AmaeyAdvait/BCD-Single-Digit-Multiplier/(list of files, drawings)

Other design files:
bcd_multiplier_Amaey_24EC10057.circ
logi7400ic (1).circ
