AmaeyAdvait/BCD-Single-Digit-Multiplier/BCD_Multiplier_Verilog/BCD_Multiplier_bcd7seg.v

// Programmer's Log: BCD_Multiplier_bcd7seg.v
// Common-anode style active-low 7-seg decoder (2 IC7447's: One to display the ten's digit
// and the other for the units.)

module BCD_multiplier_bcd7seg(
    input  [3:0] bcd,
    output reg [6:0] seg // seg = {g,f,e,d,c,b,a}
);

    always @(*) begin
        case (bcd)
            4'd0: seg = 7'b1000000;
            4'd1: seg = 7'b1111001;
            4'd2: seg = 7'b0100100;
            4'd3: seg = 7'b0110000;
            4'd4: seg = 7'b0011001;
            4'd5: seg = 7'b0010010;
            4'd6: seg = 7'b0000010;
            4'd7: seg = 7'b1111000;
            4'd8: seg = 7'b0000000;
            4'd9: seg = 7'b0010000;
            default: seg = 7'b1111111; 
        endcase
    end

endmodule
