AmaeyAdvait/BCD-Single-Digit-Multiplier/(commit log)

2026-04-16 Initial commit: TTL BCD multiplier design
    [bcd_multiplier_Amaey_24EC10057.circ]
2026-04-16 Initial commit: Supplementary file for memory ICs
    [logi7400ic (1).circ]
